SandboxElectronics/MC6805P2_clone/README.md

# MC6805P2_clone
Dumping MC6805P2 and programming MC68705P3 to emulate it

We created this project in order to fix an HP powersupply which has a failed MC6805P2. 
MC68705P3 is reprogrammable and can be used to emulate MC6805P2.

Thanks to Sean Riddle and his brilliant work on dumping and reprogramming this
Microprocessor, we were able to reproduce the dumping and reprogramming procedure
with an Arduino and a few extra components. We decided to build a dedicated board 
for those who may have similar need.

Sean's blogs:
http://www.seanriddle.com/mc6805p2.html
http://www.seanriddle.com/mc68705p5.html

The source code at GitHub:
https://github.com/SandboxElectronics/MC6805P2_clone

The board (to be updated):
http://sandboxelectronics.com
