SandboxElectronics/MC6805P2_clone/Hardware/Assembly Drawings.pdf

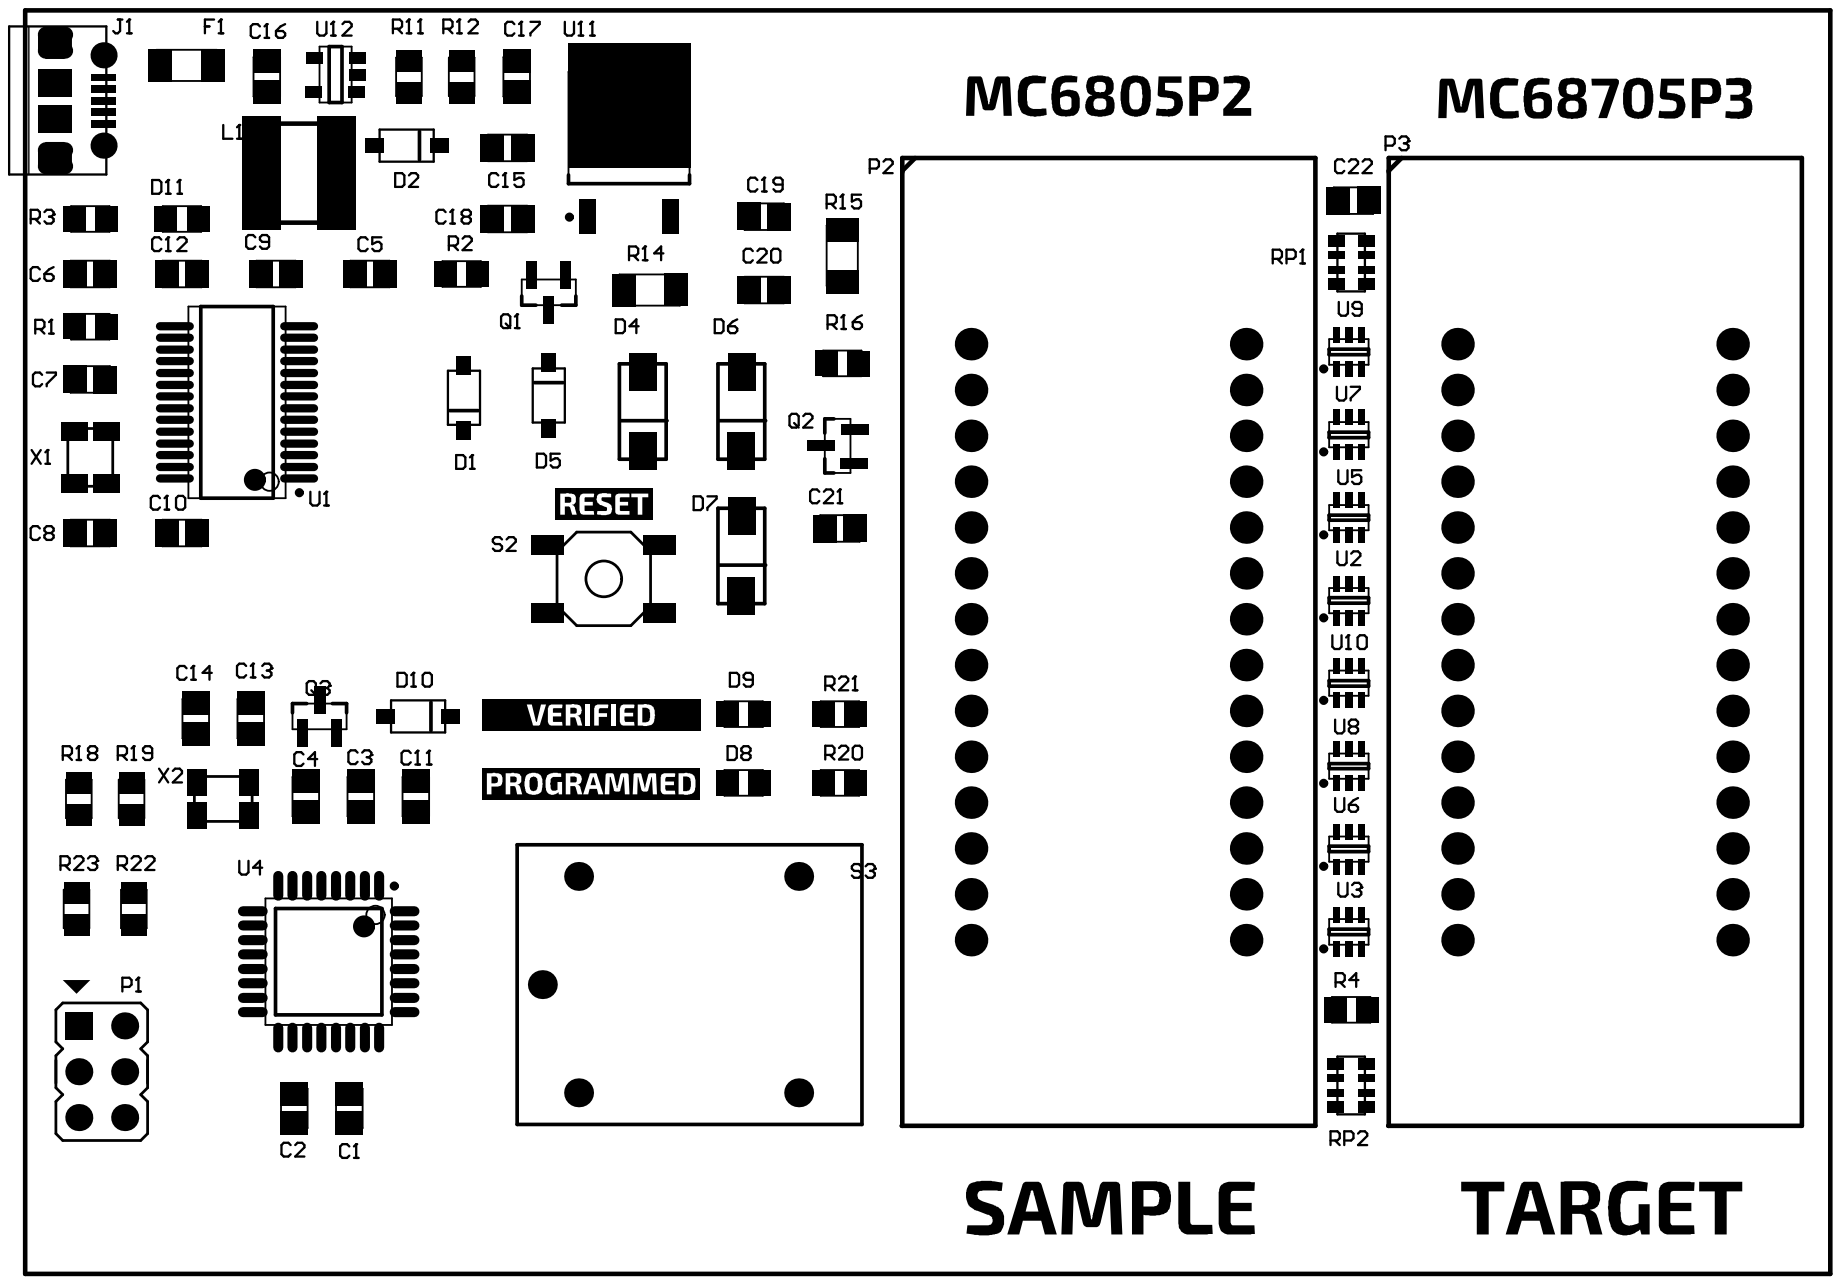
[picture p4: page 1]
